dstutman/davinci_pl2_electronics/Payload/payload.kicad_pcb

## KiCad design Payload/payload.kicad_pcb (2021-05-01)

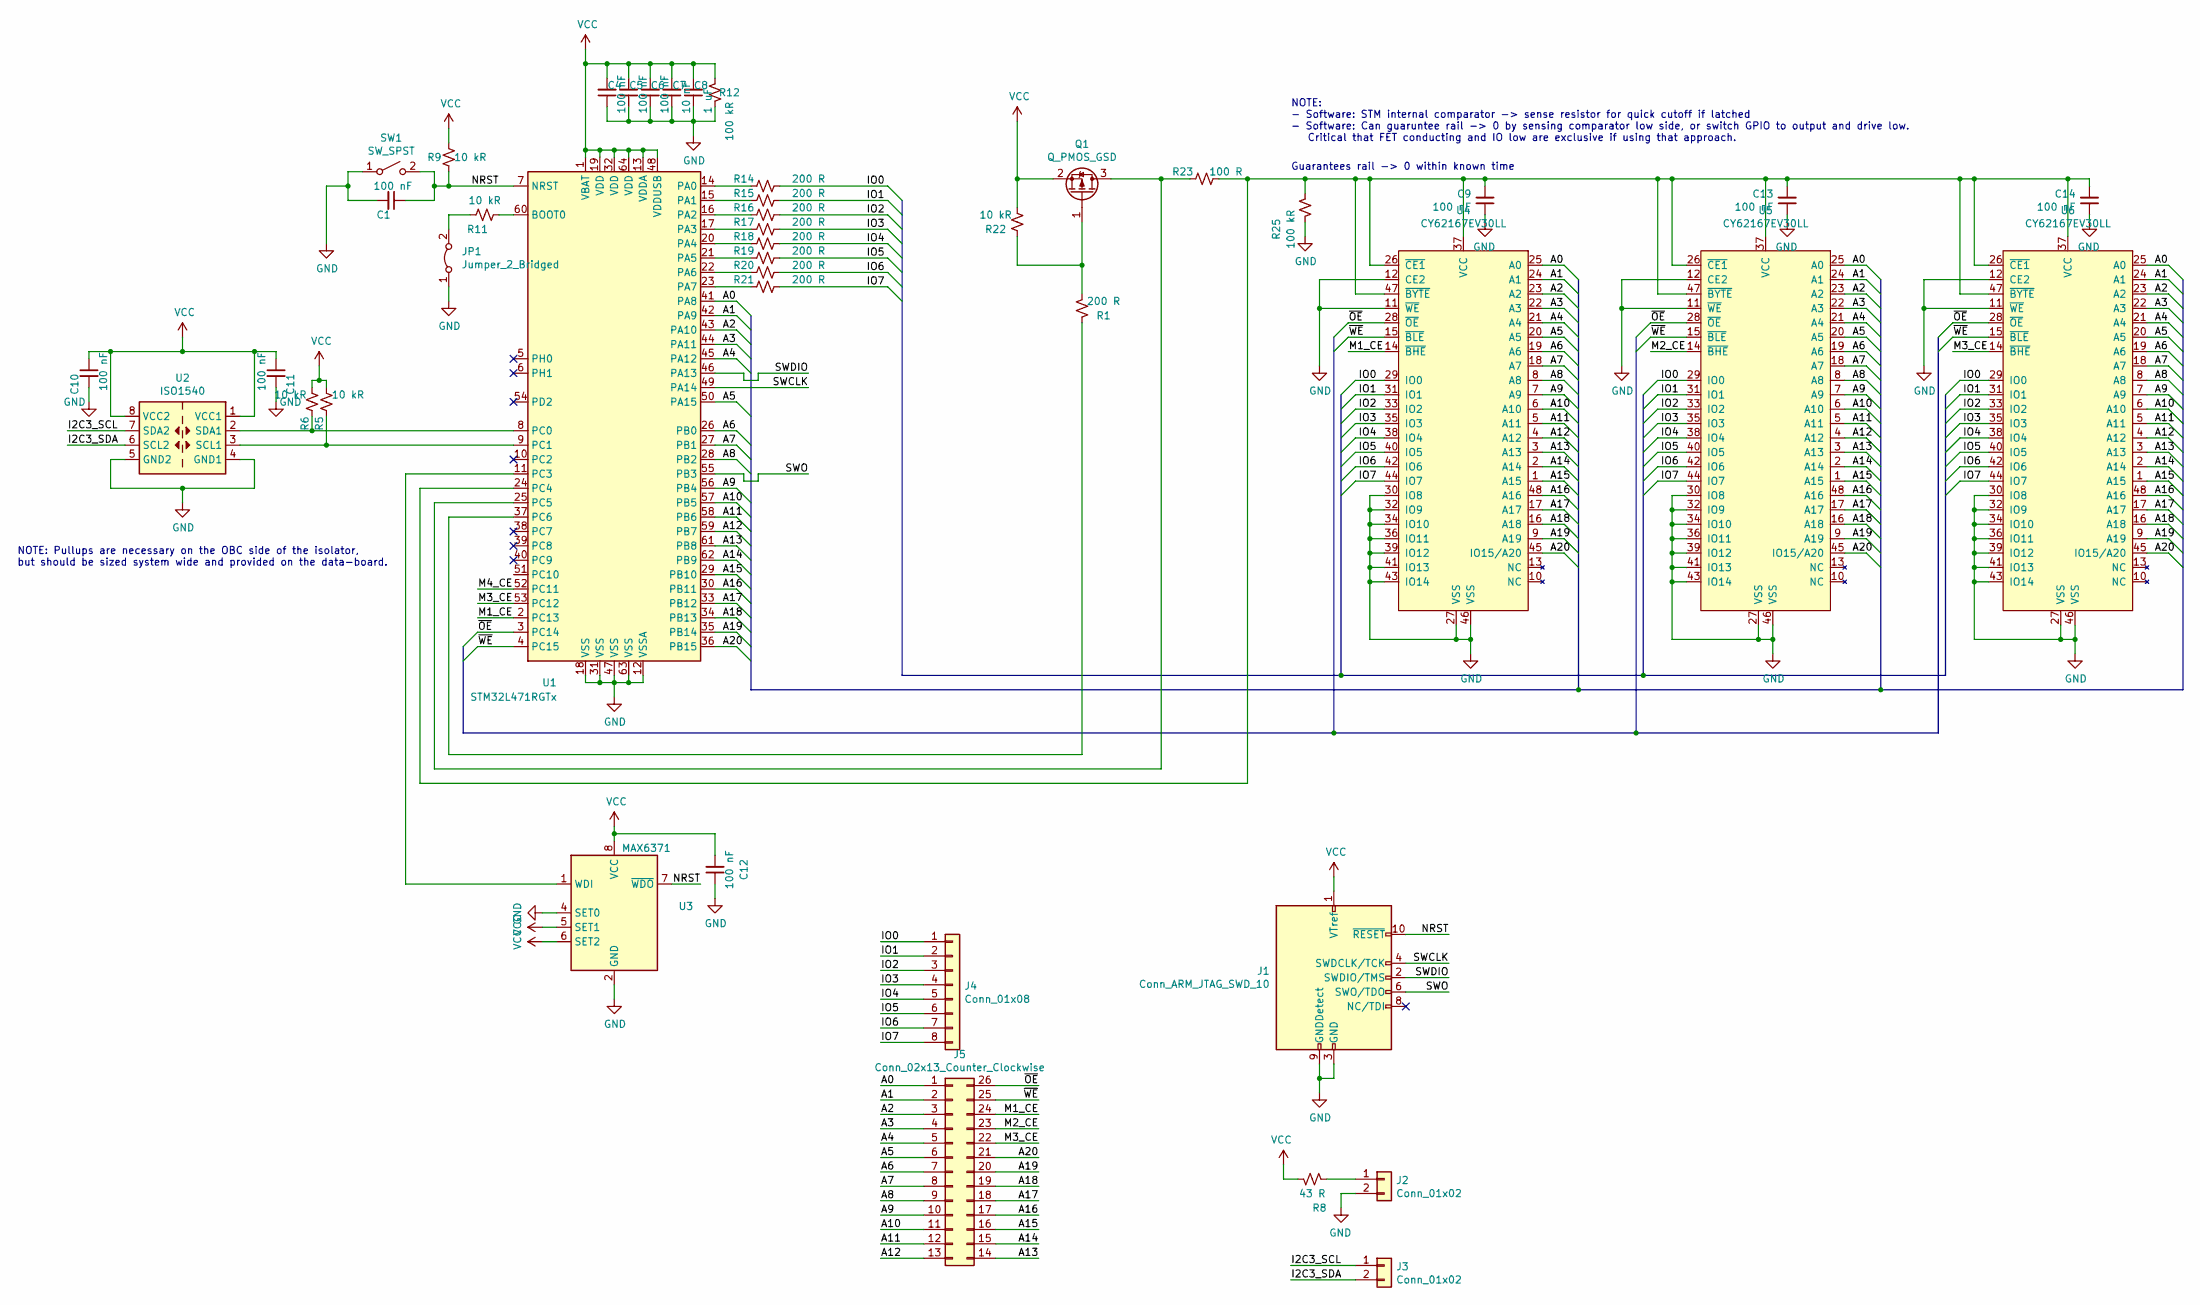
[picture p1: schematic payload.sch, Payload Two]

Parts:
C1, C4, C5, C6, C9, C10, C11, C12, C13, C14: 100 nF; C_0603_1608Metric
C7: 10 nF; C_0603_1608Metric
C8: 1 uF; C_0603_1608Metric
J1: Conn_ARM_JTAG_SWD_10; PinHeader_2x05_P1.27mm_Vertical
J2, J3: Conn_01x02; SolderWire-0.25sqmm_1x02_P4.5mm_D0.65mm_OD2mm
J4: Conn_01x08; PinHeader_1x08_P1.27mm_Vertical
J5: Conn_02x13_Counter_Clockwise; PinHeader_2x13_P1.27mm_Vertical
JP1: Jumper_2_Bridged; SolderJumper-2_P1.3mm_Bridged2Bar_RoundedPad1.0x1.5mm
Q1: Q_PMOS_GSD; SOT-23
R1, R14, R15, R16, R17, R18, R19, R20, R21: 200 R; R_0603_1608Metric
R5, R6, R9, R11, R22: 10 kR; R_0603_1608Metric
R8: 43 R; R_0603_1608Metric
R12, R25: 100 kR; R_0603_1608Metric
R23: 100 R; R_0603_1608Metric
SW1: SW_SPST; SW_SPST_PTS810
U1: STM32L471RGTx; LQFP-64_10x10mm_P0.5mm
U2: ISO1540; SOIC-8_3.9x4.9mm_P1.27mm
U3: MAX6371; SOT-23-8
U4, U5, U6: CY62167EV30LL; TSOP-I-48_18.4x12mm_P0.5mm

Connections:
/A0: J5.1, U1.41 (PA8), U4.25 (A0), U5.25 (A0), U6.25 (A0)
/A1: J5.2, U1.42 (PA9), U4.24 (A1), U5.24 (A1), U6.24 (A1)
/A2: J5.3, U1.43 (PA10), U4.23 (A2), U5.23 (A2), U6.23 (A2)
/A3: J5.4, U1.44 (PA11), U4.22 (A3), U5.22 (A3), U6.22 (A3)
/A4: J5.5, U1.45 (PA12), U4.21 (A4), U5.21 (A4), U6.21 (A4)
/A5: J5.6, U1.50 (PA15), U4.20 (A5), U5.20 (A5), U6.20 (A5)
/A6: J5.7, U1.26 (PB0), U4.19 (A6), U5.19 (A6), U6.19 (A6)
/A7: J5.8, U1.27 (PB1), U4.18 (A7), U5.18 (A7), U6.18 (A7)
/A8: J5.9, U1.28 (PB2), U4.8 (A8), U5.8 (A8), U6.8 (A8)
/A9: J5.10, U1.56 (PB4), U4.7 (A9), U5.7 (A9), U6.7 (A9)
/A10: J5.11, U1.57 (PB5), U4.6 (A10), U5.6 (A10), U6.6 (A10)
/A11: J5.12, U1.58 (PB6), U4.5 (A11), U5.5 (A11), U6.5 (A11)
/A12: J5.13, U1.59 (PB7), U4.4 (A12), U5.4 (A12), U6.4 (A12)
/A13: J5.14, U1.61 (PB8), U4.3 (A13), U5.3 (A13), U6.3 (A13)
/A14: J5.15, U1.62 (PB9), U4.2 (A14), U5.2 (A14), U6.2 (A14)
/A15: J5.16, U1.29 (PB10), U4.1 (A15), U5.1 (A15), U6.1 (A15)
/A16: J5.17, U1.30 (PB11), U4.48 (A16), U5.48 (A16), U6.48 (A16)
/A17: J5.18, U1.33 (PB12), U4.17 (A17), U5.17 (A17), U6.17 (A17)
/A18: J5.19, U1.34 (PB13), U4.16 (A18), U5.16 (A18), U6.16 (A18)
/A19: J5.20, U1.35 (PB14), U4.9 (A19), U5.9 (A19), U6.9 (A19)
/A20: J5.21, U1.36 (PB15), U4.45 (IO15/A20), U5.45 (IO15/A20), U6.45 (IO15/A20)
/I2C3_SCL: J3.1, U2.7 (SDA2)
/I2C3_SDA: J3.2, U2.6 (SCL2)
/IO0: J4.1, R14.1, U4.29 (IO0), U5.29 (IO0), U6.29 (IO0)
/IO1: J4.2, R15.1, U4.31 (IO1), U5.31 (IO1), U6.31 (IO1)
/IO2: J4.3, R16.1, U4.33 (IO2), U5.33 (IO2), U6.33 (IO2)
/IO3: J4.4, R17.1, U4.35 (IO3), U5.35 (IO3), U6.35 (IO3)
/IO4: J4.5, R18.1, U4.38 (IO4), U5.38 (IO4), U6.38 (IO4)
/IO5: J4.6, R19.1, U4.40 (IO5), U5.40 (IO5), U6.40 (IO5)
/IO6: J4.7, R20.1, U4.42 (IO6), U5.42 (IO6), U6.42 (IO6)
/IO7: J4.8, R21.1, U4.44 (IO7), U5.44 (IO7), U6.44 (IO7)
/M1_CE: J5.24, U1.2 (PC13), U4.14 (~BHE)
/M2_CE: J5.23, U5.14 (~BHE)
/M3_CE: J5.22, U1.53 (PC12), U6.14 (~BHE)
/M4_CE: U1.52 (PC11)
/NRST: C1.1, J1.10 (~RESET~), R9.2, SW1.2 (B), U1.7 (NRST), U3.7 (~WDO)
/SWCLK: J1.4 (SWDCLK/TCK), U1.49 (PA14)
/SWDIO: J1.2 (SWDIO/TMS), U1.46 (PA13)
/SWO: J1.6 (SWO/TDO), U1.55 (PB3)
/~OE: J5.26, U1.3 (PC14), U4.28 (~OE), U5.28 (~OE), U6.28 (~OE)
/~WE: J5.25, U1.4 (PC15), U4.15 (~BLE), U5.15 (~BLE), U6.15 (~BLE)
GND: C1.2, C4.1, C5.1, C6.1, C7.1, C8.1, C9.1, C10.2, C11.2, C12.1, C13.1, C14.1, J1.3 (GND), J1.5 (GND), J1.9 (GNDDetect), J2.2, JP1.1 (A), R12.2, R25.2, SW1.1 (A), U1.12 (VSSA), U1.18 (VSS), U1.31 (VSS), U1.47 (VSS), U1.63 (VSS), U2.4 (GND1), U2.5 (GND2), U3.2 (GND), U3.4 (SET0), U4.11 (~WE), U4.12 (CE2), U4.27 (VSS), U4.30 (IO8), U4.32 (IO9), U4.34 (IO10), U4.36 (IO11), U4.39 (IO12), U4.41 (IO13), U4.43 (IO14), U4.46 (VSS), U5.11 (~WE), U5.12 (CE2), U5.27 (VSS), U5.30 (IO8), U5.32 (IO9), U5.34 (IO10), U5.36 (IO11), U5.39 (IO12), U5.41 (IO13), U5.43 (IO14), U5.46 (VSS), U6.11 (~WE), U6.12 (CE2), U6.27 (VSS), U6.30 (IO8), U6.32 (IO9), U6.34 (IO10), U6.36 (IO11), U6.39 (IO12), U6.41 (IO13), U6.43 (IO14), U6.46 (VSS)
unnamed: C9.2, C13.2, C14.2, R23.2, R25.1, U1.24 (PC4), U4.26 (~CE1), U4.37 (VCC), U4.47 (~BYTE), U5.26 (~CE1), U5.37 (VCC), U5.47 (~BYTE), U6.26 (~CE1), U6.37 (VCC), U6.47 (~BYTE)
unnamed: J2.1, R8.2
unnamed: JP1.2 (B), R11.1
unnamed: Q1.1 (G), R1.2, R22.1
unnamed: Q1.3 (D), R23.1, U1.25 (PC5)
unnamed: R1.1, U1.37 (PC6)
unnamed: R5.2, U1.9 (PC1), U2.3 (SCL1)
unnamed: R6.2, U1.8 (PC0), U2.2 (SDA1)
unnamed: R11.2, U1.60 (BOOT0)
unnamed: R14.2, U1.14 (PA0)
unnamed: R15.2, U1.15 (PA1)
unnamed: R16.2, U1.16 (PA2)
unnamed: R17.2, U1.17 (PA3)
unnamed: R18.2, U1.20 (PA4)
unnamed: R19.2, U1.21 (PA5)
unnamed: R20.2, U1.22 (PA6)
unnamed: R21.2, U1.23 (PA7)
unnamed: U1.11 (PC3), U3.1 (WDI)
VCC: C4.2, C5.2, C6.2, C7.2, C8.2, C10.1, C11.1, C12.2, J1.1 (VTref), Q1.2 (S), R5.1, R6.1, R8.1, R9.1, R12.1, R22.2, U1.1 (VBAT), U1.13 (VDDA), U1.19 (VDD), U1.32 (VDD), U1.48 (VDDUSB), U1.64 (VDD), U2.1 (VCC1), U2.8 (VCC2), U3.5 (SET1), U3.6 (SET2), U3.8 (VCC)

Notes on the sheet:
NOTE: - Software: STM internal comparator -> sense resistor for quick cutoff if latched - Software: Can guaruntee rail -> 0 by sensing comparator low side, or switch GPIO to output and drive low. Critical that FET conducting and IO low are exclusive if using that approach.
Guarantees rail -> 0 within known time
NOTE: Pullups are necessary on the OBC side of the isolator, but should be sized system wide and provided on the data-board.

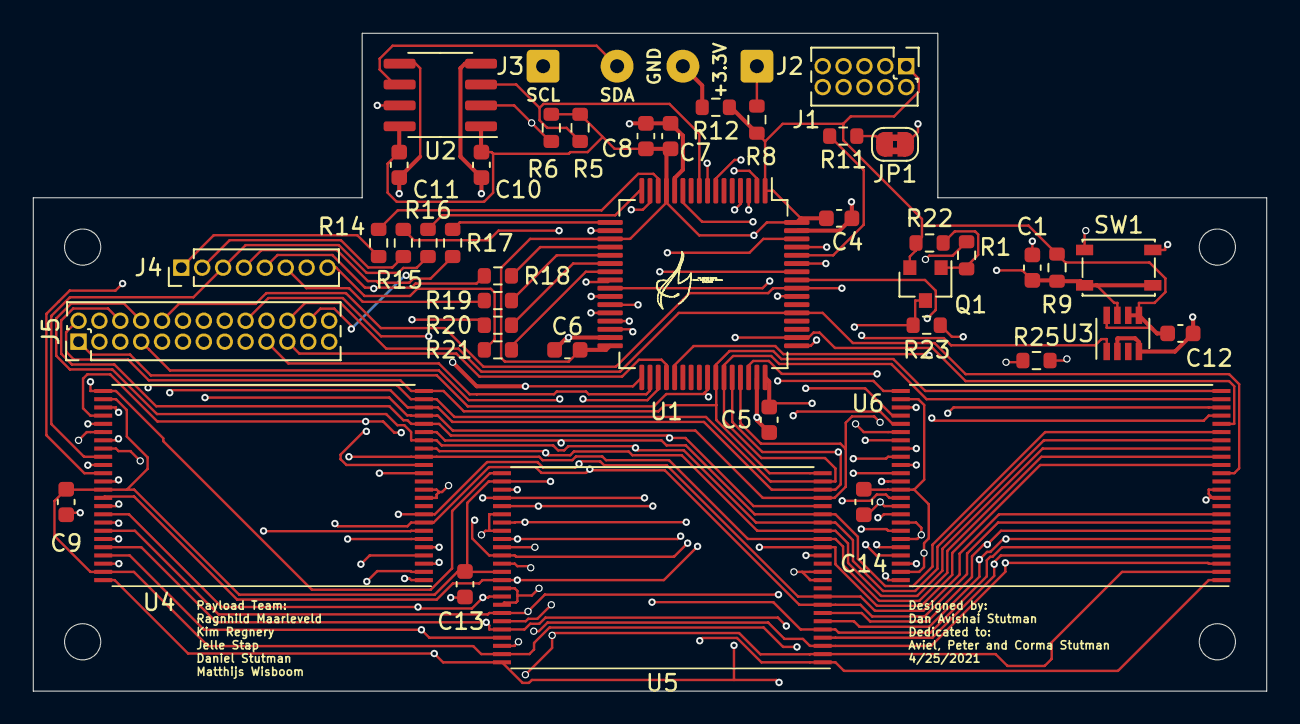
[picture p2: board payload.kicad_pcb from above]

Board: 4 copper layers, 75.0 x 40.0 mm, 44 parts (0 on the bottom side), 60 nets.
