dstutman/davinci_pl2_electronics/Devboard/devboard.kicad_pcb

## KiCad design Devboard/devboard.kicad_pcb (2021-01-17)

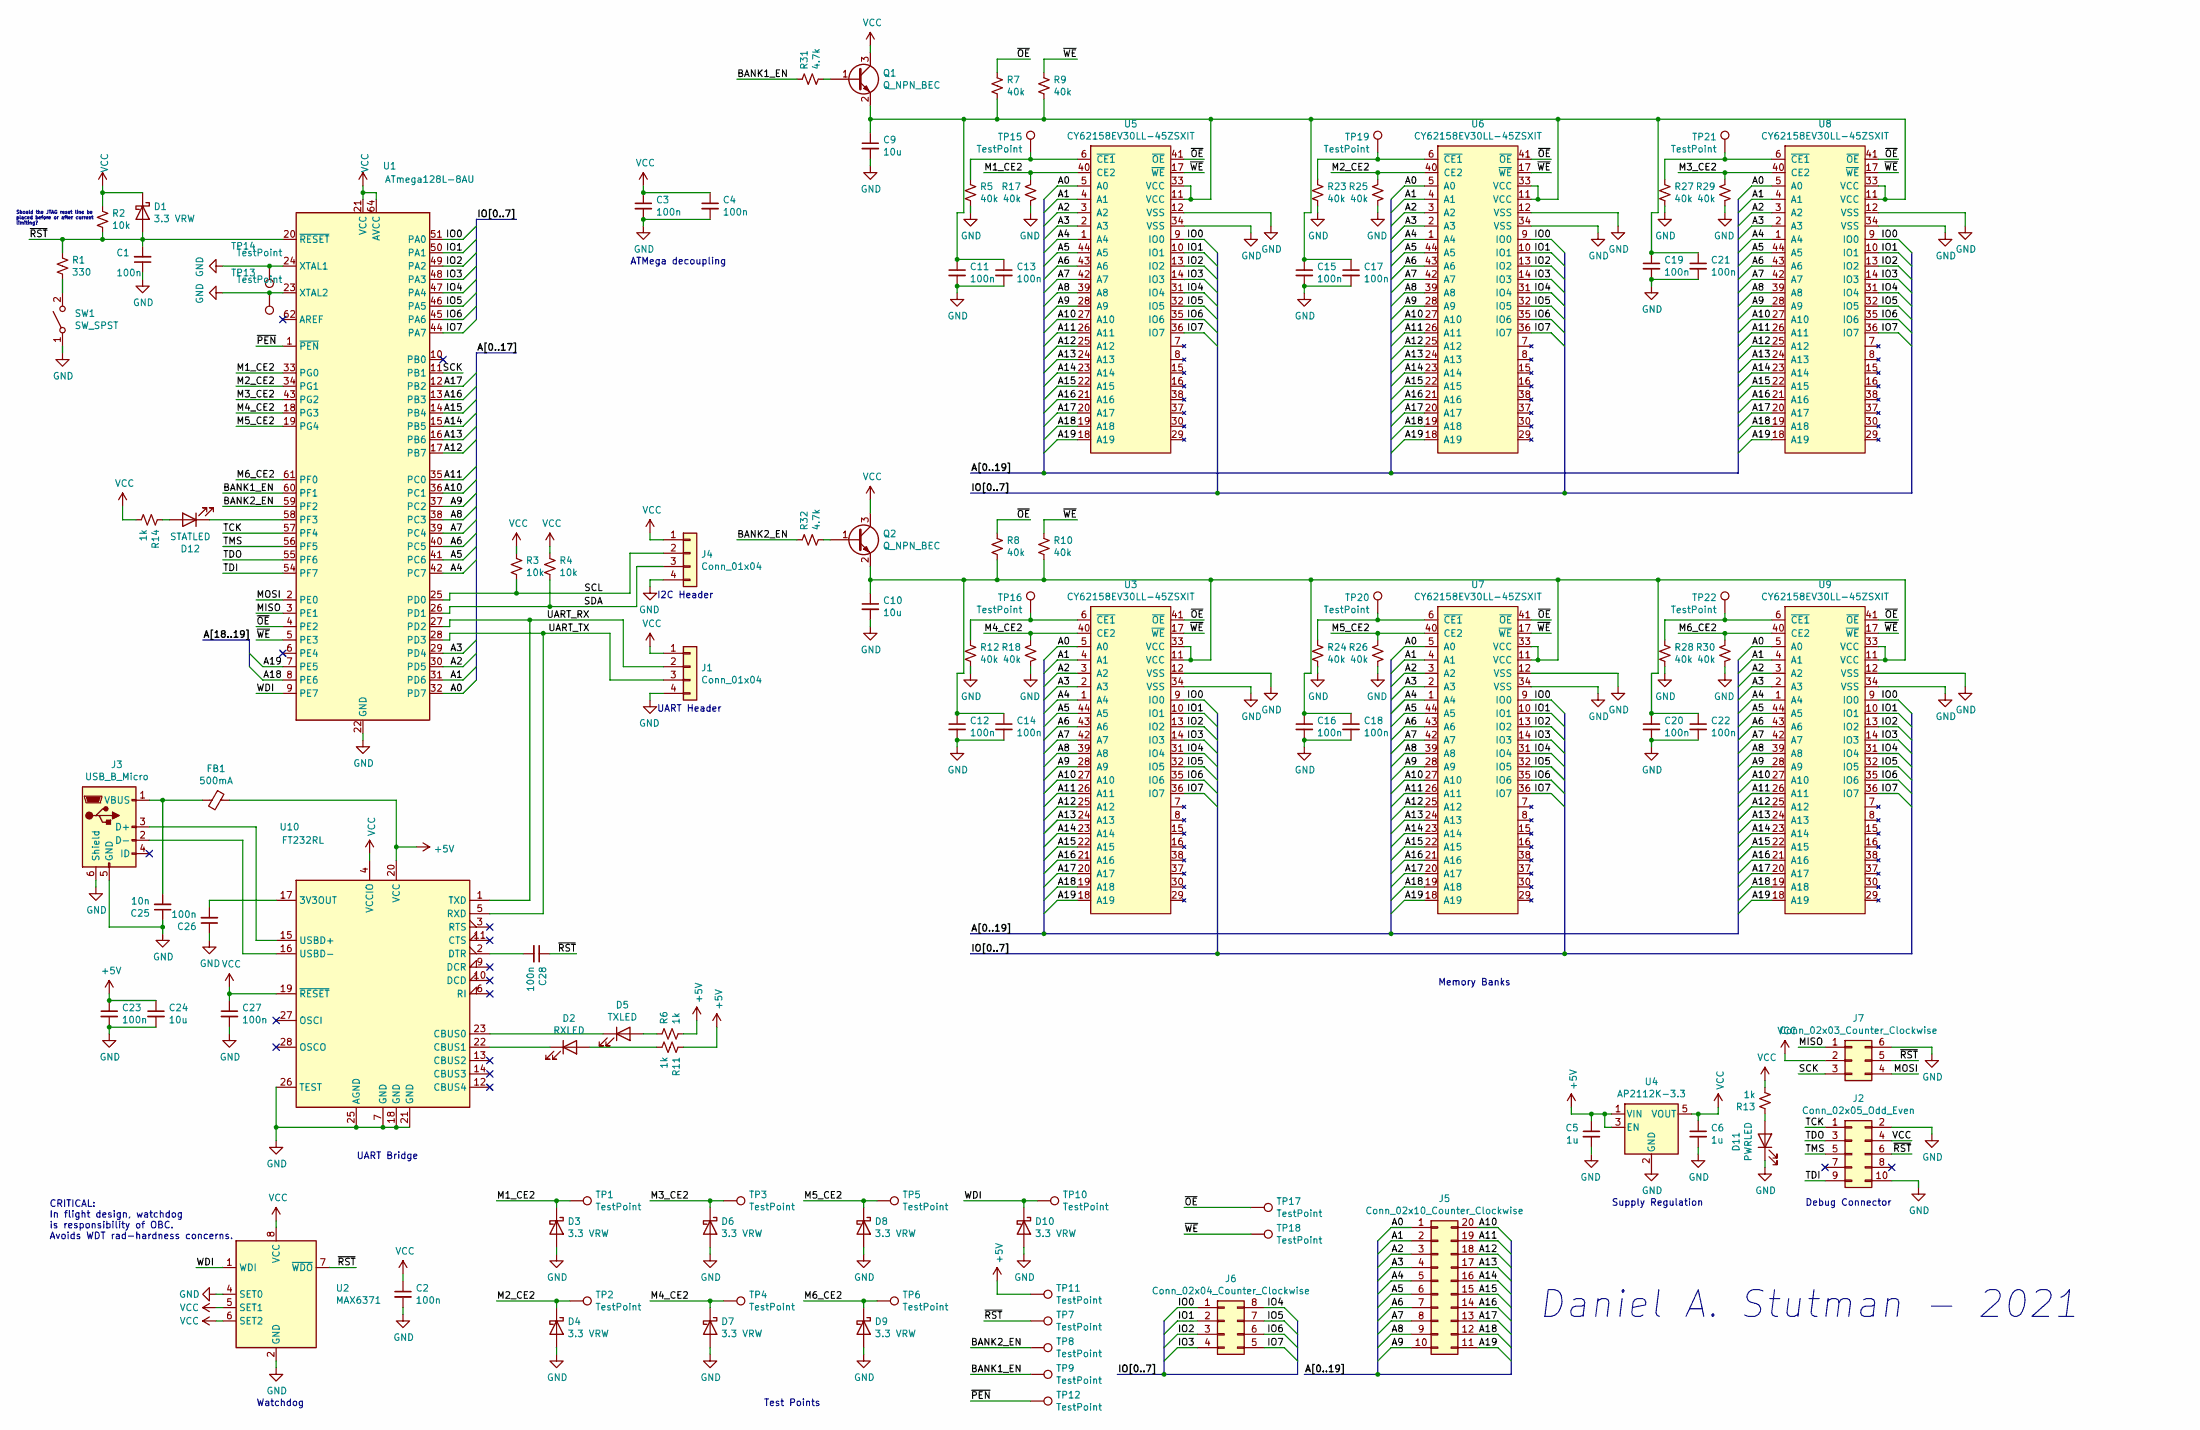
[picture p3: schematic devboard.sch, Payload 2 Development Board]

Parts:
C1, C2, C3, C4, C11, C12, C13, C14, C15, C16, C17, C18, C19, C20, C21, C22, C23, C26, C27, C28: 100n; C_0603_1608Metric_Pad1.08x0.95mm_HandSolder
C5, C6: 1u; C_0603_1608Metric_Pad1.08x0.95mm_HandSolder
C9, C10, C24: 10u; C_0603_1608Metric_Pad1.08x0.95mm_HandSolder
C25: 10n; C_0603_1608Metric_Pad1.08x0.95mm_HandSolder
D1, D3, D4, D6, D7, D8, D9, D10: 3.3 VRW; D_SOD-923
D2: RXLED; LED_0603_1608Metric_Castellated
D5: TXLED; LED_0603_1608Metric_Castellated
D11: PWRLED; LED_0603_1608Metric_Castellated
D12: STATLED; LED_0603_1608Metric_Castellated
FB1: 500mA; L_0603_1608Metric_Pad1.05x0.95mm_HandSolder
J1, J4: Conn_01x04; PinHeader_1x04_P2.54mm_Vertical
J2: Conn_02x05_Odd_Even; PinHeader_2x05_P1.27mm_Vertical
J3: USB_B_Micro; USB_Micro-B_Wuerth_629105150521
J5: Conn_02x10_Counter_Clockwise; PinHeader_2x10_P2.54mm_Vertical
J6: Conn_02x04_Counter_Clockwise; PinHeader_2x04_P2.54mm_Vertical
J7: Conn_02x03_Counter_Clockwise; PinHeader_2x03_P1.27mm_Vertical
Q1, Q2: Q_NPN_BEC; SOT-23
R1: 330; R_0603_1608Metric_Pad0.98x0.95mm_HandSolder
R2, R3, R4: 10k; R_0603_1608Metric_Pad0.98x0.95mm_HandSolder
R5, R7, R8, R9, R10, R12, R17, R18, R23, R24, R25, R26, R27, R28, R29, R30: 40k; R_0603_1608Metric_Pad0.98x0.95mm_HandSolder
R6, R11, R13, R14: 1k; R_0603_1608Metric_Pad0.98x0.95mm_HandSolder
R31, R32: 4.7k; R_0603_1608Metric_Pad0.98x0.95mm_HandSolder
SW1: SW_SPST; SW_SPST_PTS810
TP1, TP2, TP3, TP4, TP5, TP6, TP7, TP8, TP9, TP10, TP11, TP12, TP17, TP18: TestPoint; PinHeader_1x01_P2.54mm_Vertical
TP13, TP14: TestPoint; TestPoint_Bridge_Pitch2.54mm_Drill0.7mm
TP15, TP16, TP19, TP20, TP21, TP22: TestPoint; TestPoint_Pad_D1.5mm
U1: ATmega128L-8AU; TQFP-64_14x14mm_P0.8mm
U2: MAX6371; SOT-23-8
U3, U5, U6, U7, U8, U9: CY62158EV30LL-45ZSXIT; TSOP-II-44_10.16x18.41mm_P0.8mm
U4: AP2112K-3.3; SOT-23-5
U10: FT232RL; SSOP-28_5.3x10.2mm_P0.65mm

Connections:
+5V: C5.1, C23.1, C24.1, FB1.1, R6.2, R11.1, TP11.1, U4.1 (VIN), U4.3 (EN), U10.20 (VCC)
/A0: J5.1, U1.32 (PD7), U3.5 (A0), U5.5 (A0), U6.5 (A0), U7.5 (A0), U8.5 (A0), U9.5 (A0)
/A1: J5.2, U1.31 (PD6), U3.4 (A1), U5.4 (A1), U6.4 (A1), U7.4 (A1), U8.4 (A1), U9.4 (A1)
/A2: J5.3, U1.30 (PD5), U3.3 (A2), U5.3 (A2), U6.3 (A2), U7.3 (A2), U8.3 (A2), U9.3 (A2)
/A3: J5.4, U1.29 (PD4), U3.2 (A3), U5.2 (A3), U6.2 (A3), U7.2 (A3), U8.2 (A3), U9.2 (A3)
/A4: J5.5, U1.42 (PC7), U3.1 (A4), U5.1 (A4), U6.1 (A4), U7.1 (A4), U8.1 (A4), U9.1 (A4)
/A5: J5.6, U1.41 (PC6), U3.44 (A5), U5.44 (A5), U6.44 (A5), U7.44 (A5), U8.44 (A5), U9.44 (A5)
/A6: J5.7, U1.40 (PC5), U3.43 (A6), U5.43 (A6), U6.43 (A6), U7.43 (A6), U8.43 (A6), U9.43 (A6)
/A7: J5.8, U1.39 (PC4), U3.42 (A7), U5.42 (A7), U6.42 (A7), U7.42 (A7), U8.42 (A7), U9.42 (A7)
/A8: J5.9, U1.38 (PC3), U3.39 (A8), U5.39 (A8), U6.39 (A8), U7.39 (A8), U8.39 (A8), U9.39 (A8)
/A9: J5.10, U1.37 (PC2), U3.28 (A9), U5.28 (A9), U6.28 (A9), U7.28 (A9), U8.28 (A9), U9.28 (A9)
/A10: J5.20, U1.36 (PC1), U3.27 (A10), U5.27 (A10), U6.27 (A10), U7.27 (A10), U8.27 (A10), U9.27 (A10)
/A11: J5.19, U1.35 (PC0), U3.26 (A11), U5.26 (A11), U6.26 (A11), U7.26 (A11), U8.26 (A11), U9.26 (A11)
/A12: J5.18, U1.17 (PB7), U3.25 (A12), U5.25 (A12), U6.25 (A12), U7.25 (A12), U8.25 (A12), U9.25 (A12)
/A13: J5.17, U1.16 (PB6), U3.24 (A13), U5.24 (A13), U6.24 (A13), U7.24 (A13), U8.24 (A13), U9.24 (A13)
/A14: J5.16, U1.15 (PB5), U3.23 (A14), U5.23 (A14), U6.23 (A14), U7.23 (A14), U8.23 (A14), U9.23 (A14)
/A15: J5.15, U1.14 (PB4), U3.22 (A15), U5.22 (A15), U6.22 (A15), U7.22 (A15), U8.22 (A15), U9.22 (A15)
/A16: J5.14, U1.13 (PB3), U3.21 (A16), U5.21 (A16), U6.21 (A16), U7.21 (A16), U8.21 (A16), U9.21 (A16)
/A17: J5.13, U1.12 (PB2), U3.20 (A17), U5.20 (A17), U6.20 (A17), U7.20 (A17), U8.20 (A17), U9.20 (A17)
/A18: J5.12, U1.8 (PE6), U3.19 (A18), U5.19 (A18), U6.19 (A18), U7.19 (A18), U8.19 (A18), U9.19 (A18)
/A19: J5.11, U1.7 (PE5), U3.18 (A19), U5.18 (A19), U6.18 (A19), U7.18 (A19), U8.18 (A19), U9.18 (A19)
/BANK1_EN: R31.1, TP9.1, U1.60 (PF1)
/BANK2_EN: R32.1, TP8.1, U1.59 (PF2)
/IO0: J6.1, U1.51 (PA0), U3.9 (IO0), U5.9 (IO0), U6.9 (IO0), U7.9 (IO0), U8.9 (IO0), U9.9 (IO0)
/IO1: J6.2, U1.50 (PA1), U3.10 (IO1), U5.10 (IO1), U6.10 (IO1), U7.10 (IO1), U8.10 (IO1), U9.10 (IO1)
/IO2: J6.3, U1.49 (PA2), U3.13 (IO2), U5.13 (IO2), U6.13 (IO2), U7.13 (IO2), U8.13 (IO2), U9.13 (IO2)
/IO3: J6.4, U1.48 (PA3), U3.14 (IO3), U5.14 (IO3), U6.14 (IO3), U7.14 (IO3), U8.14 (IO3), U9.14 (IO3)
/IO4: J6.8, U1.47 (PA4), U3.31 (IO4), U5.31 (IO4), U6.31 (IO4), U7.31 (IO4), U8.31 (IO4), U9.31 (IO4)
/IO5: J6.7, U1.46 (PA5), U3.32 (IO5), U5.32 (IO5), U6.32 (IO5), U7.32 (IO5), U8.32 (IO5), U9.32 (IO5)
/IO6: J6.6, U1.45 (PA6), U3.35 (IO6), U5.35 (IO6), U6.35 (IO6), U7.35 (IO6), U8.35 (IO6), U9.35 (IO6)
/IO7: J6.5, U1.44 (PA7), U3.36 (IO7), U5.36 (IO7), U6.36 (IO7), U7.36 (IO7), U8.36 (IO7), U9.36 (IO7)
/M1_CE2: D3.1 (K), R17.2, TP1.1, U1.33 (PG0), U5.40 (CE2)
/M2_CE2: D4.1 (K), R25.2, TP2.1, U1.34 (PG1), U6.40 (CE2)
/M3_CE2: D6.1 (K), R29.2, TP3.1, U1.43 (PG2), U8.40 (CE2)
/M4_CE2: D7.1 (K), R18.2, TP4.1, U1.18 (PG3), U3.40 (CE2)
/M5_CE2: D8.1 (K), R26.2, TP5.1, U1.19 (PG4), U7.40 (CE2)
/M6_CE2: D9.1 (K), R30.2, TP6.1, U1.61 (PF0), U9.40 (CE2)
/MISO: J7.1, U1.3 (PE1)
/MOSI: J7.4, U1.2 (PE0)
/SCK: J7.3, U1.11 (PB1)
/SCL: J4.2, R3.2, U1.25 (PD0)
/SDA: J4.3, R4.2, U1.26 (PD1)
/TCK: J2.1, U1.57 (PF4)
/TDI: J2.9, U1.54 (PF7)
/TDO: J2.3, U1.55 (PF6)
/TMS: J2.5, U1.56 (PF5)
/UART_RX: J1.2, U1.27 (PD2), U10.1 (TXD)
/UART_TX: J1.3, U1.28 (PD3), U10.5 (RXD)
/WDI: D10.1 (K), TP10.1, U1.9 (PE7), U2.1 (WDI)
/~OE: R7.2, R8.2, TP17.1, U1.4 (PE2), U3.41 (~OE), U5.41 (~OE), U6.41 (~OE), U7.41 (~OE), U8.41 (~OE), U9.41 (~OE)
/~PEN: TP12.1, U1.1 (~PEN)
/~RST: C1.2, C28.1, D1.2 (A), J2.6, J7.5, R1.1, R2.2, TP7.1, U1.20 (~RESET), U2.7 (~WDO)
/~WE: R9.2, R10.2, TP18.1, U1.5 (PE3), U3.17 (~WE), U5.17 (~WE), U6.17 (~WE), U7.17 (~WE), U8.17 (~WE), U9.17 (~WE)
GND: C1.1, C2.2, C3.2, C4.2, C5.2, C6.2, C9.2, C10.2, C11.2, C12.2, C13.2, C14.2, C15.2, C16.2, C17.2, C18.2, C19.2, C20.2, C21.2, C22.2, C23.2, C24.2, C25.1, C26.1, C27.2, D3.2 (A), D4.2 (A), D6.2 (A), D7.2 (A), D8.2 (A), D9.2 (A), D10.2 (A), D11.1 (K), J1.4, J2.2, J2.10, J3.5 (GND), J3.6 (Shield), J4.4, J7.6, R5.1, R12.1, R17.1, R18.1, R23.1, R24.1, R25.1, R26.1, R27.1, R28.1, R29.1, R30.1, SW1.1 (A), TP13.1, TP14.1, U1.22 (GND), U1.23 (XTAL2), U1.24 (XTAL1), U1.53 (GND), U1.63 (GND), U2.2 (GND), U2.4 (SET0), U3.12 (VSS), U3.34 (VSS), U4.2 (GND), U5.12 (VSS), U5.34 (VSS), U6.12 (VSS), U6.34 (VSS), U7.12 (VSS), U7.34 (VSS), U8.12 (VSS), U8.34 (VSS), U9.12 (VSS), U9.34 (VSS), U10.7 (GND), U10.18 (GND), U10.21 (GND), U10.25 (AGND), U10.26 (TEST)
unnamed: C10.1, C12.1, C14.1, C16.1, C18.1, C20.1, C22.1, Q2.2 (E), R8.1, R10.1, U3.11 (VCC), U3.33 (VCC), U7.11 (VCC), U7.33 (VCC), U9.11 (VCC), U9.33 (VCC)
unnamed: C9.1, C11.1, C13.1, C15.1, C17.1, C19.1, C21.1, Q1.2 (E), R7.1, R9.1, U5.11 (VCC), U5.33 (VCC), U6.11 (VCC), U6.33 (VCC), U8.11 (VCC), U8.33 (VCC)
unnamed: C25.2, FB1.2, J3.1 (VBUS)
unnamed: C26.2, U10.17 (3V3OUT)
unnamed: C28.2, U10.2 (DTR)
unnamed: D2.1 (K), U10.22 (CBUS1)
unnamed: D2.2 (A), R11.2
unnamed: D5.1 (K), U10.23 (CBUS0)
unnamed: D5.2 (A), R6.1
unnamed: D11.2 (A), R13.1
unnamed: D12.1 (K), U1.58 (PF3)
unnamed: D12.2 (A), R14.1
unnamed: J3.2 (D-), U10.16 (USBD-)
unnamed: J3.3 (D+), U10.15 (USBD+)
unnamed: Q1.1 (B), R31.2
unnamed: Q2.1 (B), R32.2
unnamed: R1.2, SW1.2 (B)
unnamed: R5.2, TP15.1, U5.6 (~CE1)
unnamed: R12.2, TP16.1, U3.6 (~CE1)
unnamed: R23.2, TP19.1, U6.6 (~CE1)
unnamed: R24.2, TP20.1, U7.6 (~CE1)
unnamed: R27.2, TP21.1, U8.6 (~CE1)
unnamed: R28.2, TP22.1, U9.6 (~CE1)
VCC: C2.1, C3.1, C4.1, C6.1, C27.1, D1.1 (K), J1.1, J2.4, J4.1, J7.2, Q1.3 (C), Q2.3 (C), R2.1, R3.1, R4.1, R13.2, R14.2, U1.21 (VCC), U1.52 (VCC), U1.64 (AVCC), U2.5 (SET1), U2.6 (SET2), U2.8 (VCC), U4.5 (VOUT), U10.4 (VCCIO), U10.19 (~RESET~)

Notes on the sheet:
ATMega decoupling
Should the JTAG reset line be placed before or after current limiting?
Watchdog
CRITICAL: In flight design, watchdog is responsibility of OBC. Avoids WDT rad-hardness concerns.
UART Header
I2C Header
Supply Regulation
Debug Connector
Test Points
UART Bridge
Daniel A. Stutman - 2021
Memory Banks

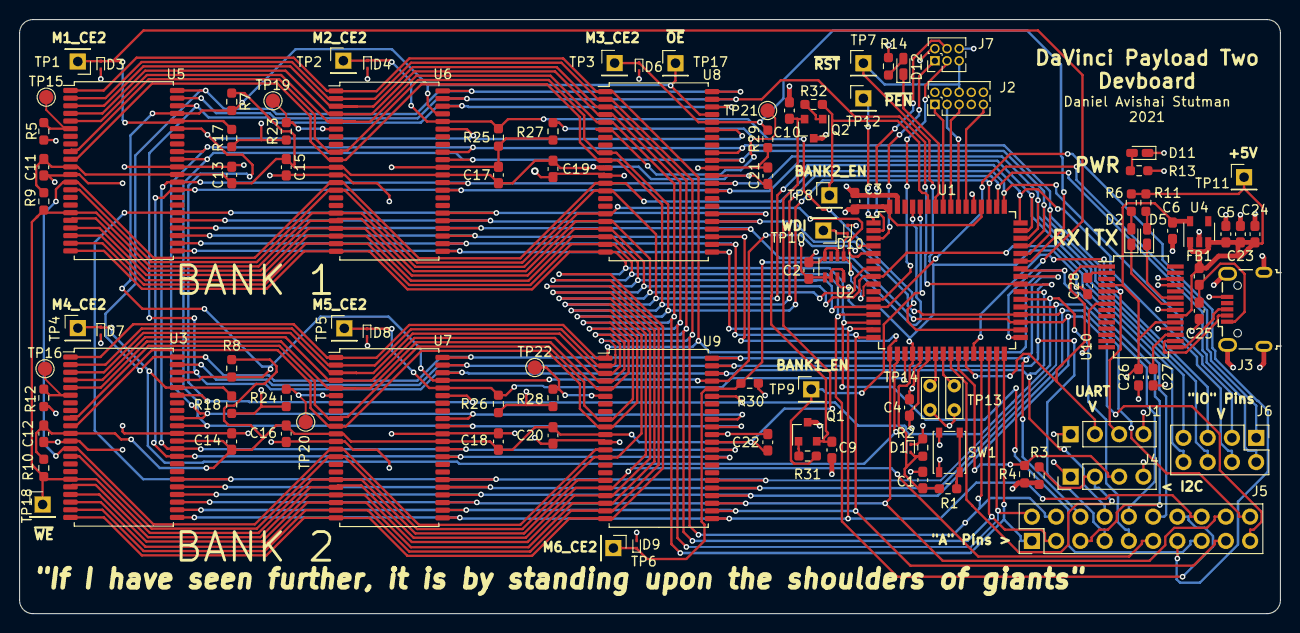
[picture p4: board devboard.kicad_pcb from above]

Board: 4 copper layers, 132.1 x 62.2 mm, 107 parts (0 on the bottom side), 78 nets.
