dstutman/davinci_pl2_electronics/(commit log)

2020-12-19 Add hardware projects
    [databoard.kicad_pcb, databoard.sch, devboard.kicad_pcb, devboard.sch, mainboard.kicad_pcb, mainboard.sch]
2020-12-19 Add documentation and initial work on devboard
    [devboard.sch]
2020-12-19 Tie xtal pins to ground for now
    [devboard.sch]
2020-12-19 Add memory banks
    [devboard.sch]
2020-12-20 Add more memory, watchdog, buffers, test points
    [devboard.sch]
2020-12-20 Add LDO for 5V supply
    [devboard.sch]
2020-12-20 Add breakout header
    [devboard.kicad_pcb, devboard.sch]
2020-12-20 Complete draft schematic
    [devboard.sch]
2020-12-21 Fix critical error
    [devboard.sch]
2020-12-29 Work on SRAMBB prototype
    [devboard.sch]
2021-01-03 Improved supercap circuit
    [devboard.sch]
2021-01-08 Move to new project structure
    [databoard.kicad_pcb, databoard.sch, devboard.kicad_pcb, devboard.sch, mainboard.kicad_pcb, mainboard.sch]
2021-01-10 Remove backup power section
    [devboard.sch]
2021-01-10 Add CY62158EV30 footprint
2021-01-10 Reorder pins on Cypress SRAM
    [devboard.sch]
2021-01-10 Complete SRAM schematic draft
    [devboard.sch]
2021-01-10 Correct errors and assign footprints
    [devboard.sch]
2021-01-10 Correct BJT base resistors values
    [devboard.sch]
2021-01-10 Change schematic title
    [devboard.sch]
2021-01-10 Add 5V testpoint
    [devboard.sch]
2021-01-10 Improve schematic labeling
    [devboard.sch]
2021-01-10 Remove bad old smudge filter note
2021-01-11 Fix attribution
    [devboard.sch]
2021-01-11 Fix UART lines
    [devboard.sch]
2021-01-11 Mark unconnected pins
    [devboard.sch]
2021-01-11 Schematic cohesion improvements
    [devboard.sch]
2021-01-14 Fix memory decoupling
    [devboard.sch]
2021-01-14 Exploration into bus layout
    This commit made to save progress before attempting new layout.
    [devboard.kicad_pcb]
2021-01-14 Fix missing pin assignments and excessive pulls
    [devboard.sch]
2021-01-14 Successfully route memories
    [devboard.kicad_pcb, devboard.sch]
2021-01-14 Join memory busses
    [devboard.kicad_pcb]
2021-01-15 Routing almost complete
    [devboard.kicad_pcb, devboard.sch]
2021-01-15 Autorouting pass
    [devboard.kicad_pcb]
2021-01-15 Improve silk
    [devboard.kicad_pcb]
2021-01-15 Slight via improvements
    [devboard.kicad_pcb]
2021-01-15 Rounded borders
    [devboard.kicad_pcb]
2021-01-15 Labeling correction
    [devboard.kicad_pcb]
2021-01-16 Fix pullup connections and minor silk alterations
    [devboard.kicad_pcb, devboard.sch]
2021-01-16 Add power indicator and improve silk
    [devboard.kicad_pcb, devboard.sch]
2021-01-16 Net cleanup
    Ran the KiCAD net cleanup tool with all options enabled. This created
    a lot of commit noise, but none of this functionally changes the circit.
    [devboard.kicad_pcb]
2021-01-16 Annotation update
    [devboard.sch]
2021-01-16 Remove extraneous wire
    [devboard.sch]
2021-01-16 SPI programming and silk improvements
    [devboard.kicad_pcb, devboard.sch]
2021-01-17 Add crystal pads, MCU LED, fix serial routing
    [devboard.kicad_pcb, devboard.sch]
2021-01-17 Add more testpoints
    Just in case the Cypress chip operates differently than advertised.
    [devboard.kicad_pcb, devboard.sch]
2021-01-17 Small fixes to clock pads
    [devboard.kicad_pcb]
2021-02-07 Move devboard into new directory structure
    [devboard.kicad_pcb, devboard.sch]
2021-02-07 Initialize payload project
    [memory_module.kicad_pcb, memory_module.sch, processing_module.kicad_pcb, processing_module.sch]
2021-03-01 Work on power control for memory module
    Forgot to commit so this is old, I believe this is what changed.
2021-03-03 Work on inter-board connectors
    [memory_module.sch]
2021-03-10 Work on new single board design with commercial MCU.
    [payload.kicad_pcb, payload.sch]
2021-03-14 Work on bus and power
    [payload.sch]
2021-03-14 Progress on bus
    [payload.sch]
2021-03-16 Hook up chip controls and some power stuff
    [payload.sch]
2021-03-22 Current limiting resistor and implementation notes
    [payload.sch]
2021-03-22 Add additional TODO
    [payload.sch]
2021-03-28 Testpoints, specific values, CE, series protection, crystal, headers.
    [file607F414D.sch, payload.sch]
2021-04-01 Connectors, notes, general cleanup
    [payload.sch]
2021-04-02 Fix missing gate resistors
    [payload.sch]
2021-04-18 Add I2C isolation
    [payload.sch]
2021-04-20 Add watchdog and I2C isolator
    [payload.sch]
2021-04-20 Replace old memory symbol
    [payload.sch]
2021-04-22 Cosmetic changes
    [payload.sch]
2021-04-22 Assign footprints
    [payload.sch]
2021-04-22 Schematic fixes and routing
2021-04-25 Partial routing
    [payload.kicad_pcb, payload.sch]
2021-04-25 Reduced BOM to fit, routed
    [payload.kicad_pcb, payload.sch]
2021-04-25 Silk corrections and fix routes
    [payload.kicad_pcb]
2021-04-26 Correct silk violations
    [payload.kicad_pcb]
2021-04-30 Modify silk
    [payload.kicad_pcb]
2021-05-01 Update component values and isolator
    [payload.kicad_pcb, payload.sch]
